parkview/blot/hardware/motor-control-board/circuit/V2_PH/motor-controller-pcb/Screenshots/Blot_PCB_Front_v2.1b1.png

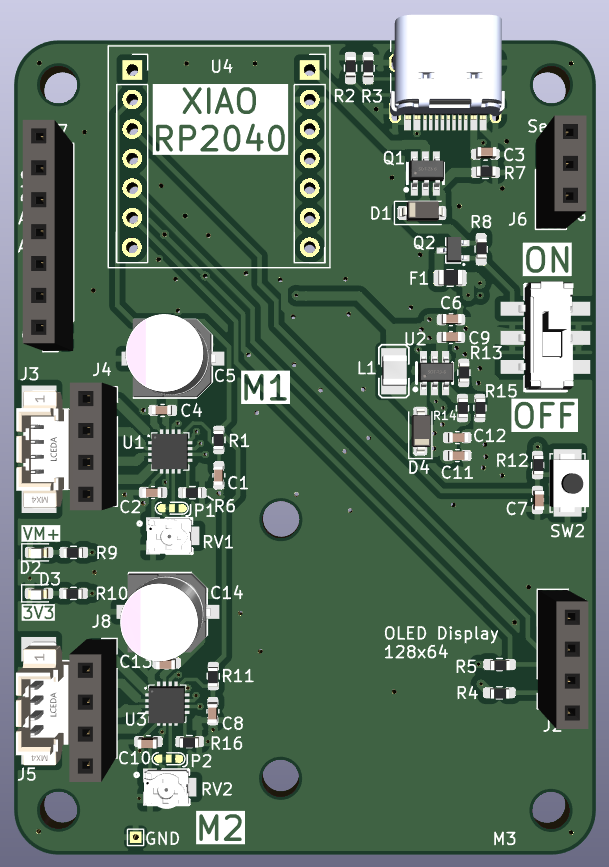
hardware/motor-control-board/circuit/V2_PH/motor-controller-pcb/Screenshots/Blot_PCB_Front_v2.1b1.png
