parkview/blot/hardware/motor-control-board/circuit/V2_PH/motor-controller-pcb/Version_2.1b1/Boost-Resistor-Selection.ods

FP6291LR-G1 Boost Resistor Selection
Vin | 5
R9 (R2) | 12000
R8 (R1) | 168000
Vout | 9
R8 = ((Vout/0.6) - 1) *R9
