parkview/blot/hardware/motor-control-board/circuit/V2_PH/motor-controller-pcb/blot_motor-controller_schematic_v2.2b1.pdf

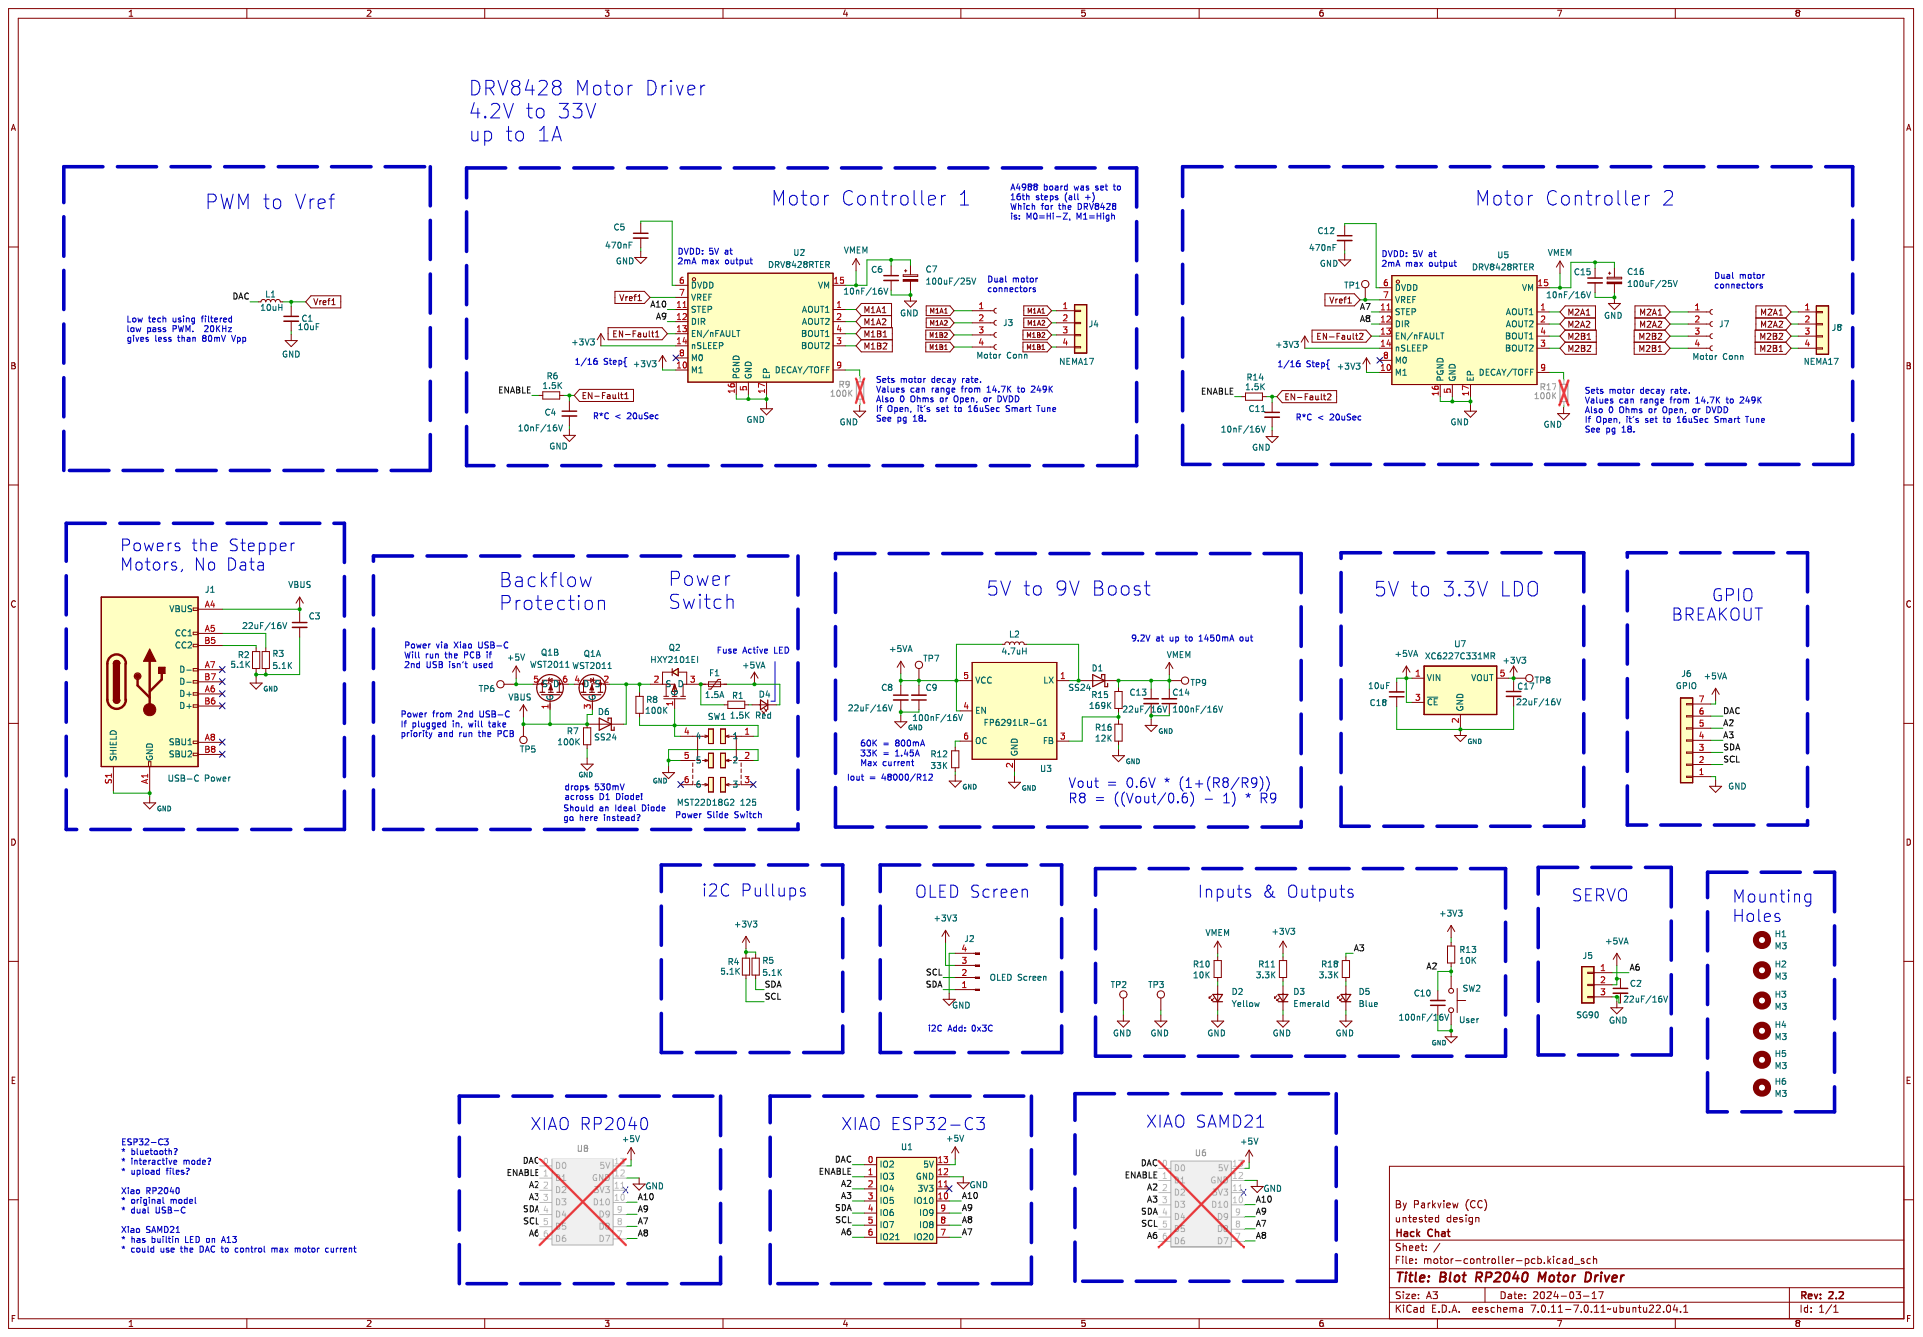
[picture p5: page 1]
