parkview/blot/hardware/motor-control-board/circuit/V2_PH/motor-controller-pcb/Version_2.1b1/blot_motor-controller_schematic_v2.1b5.pdf

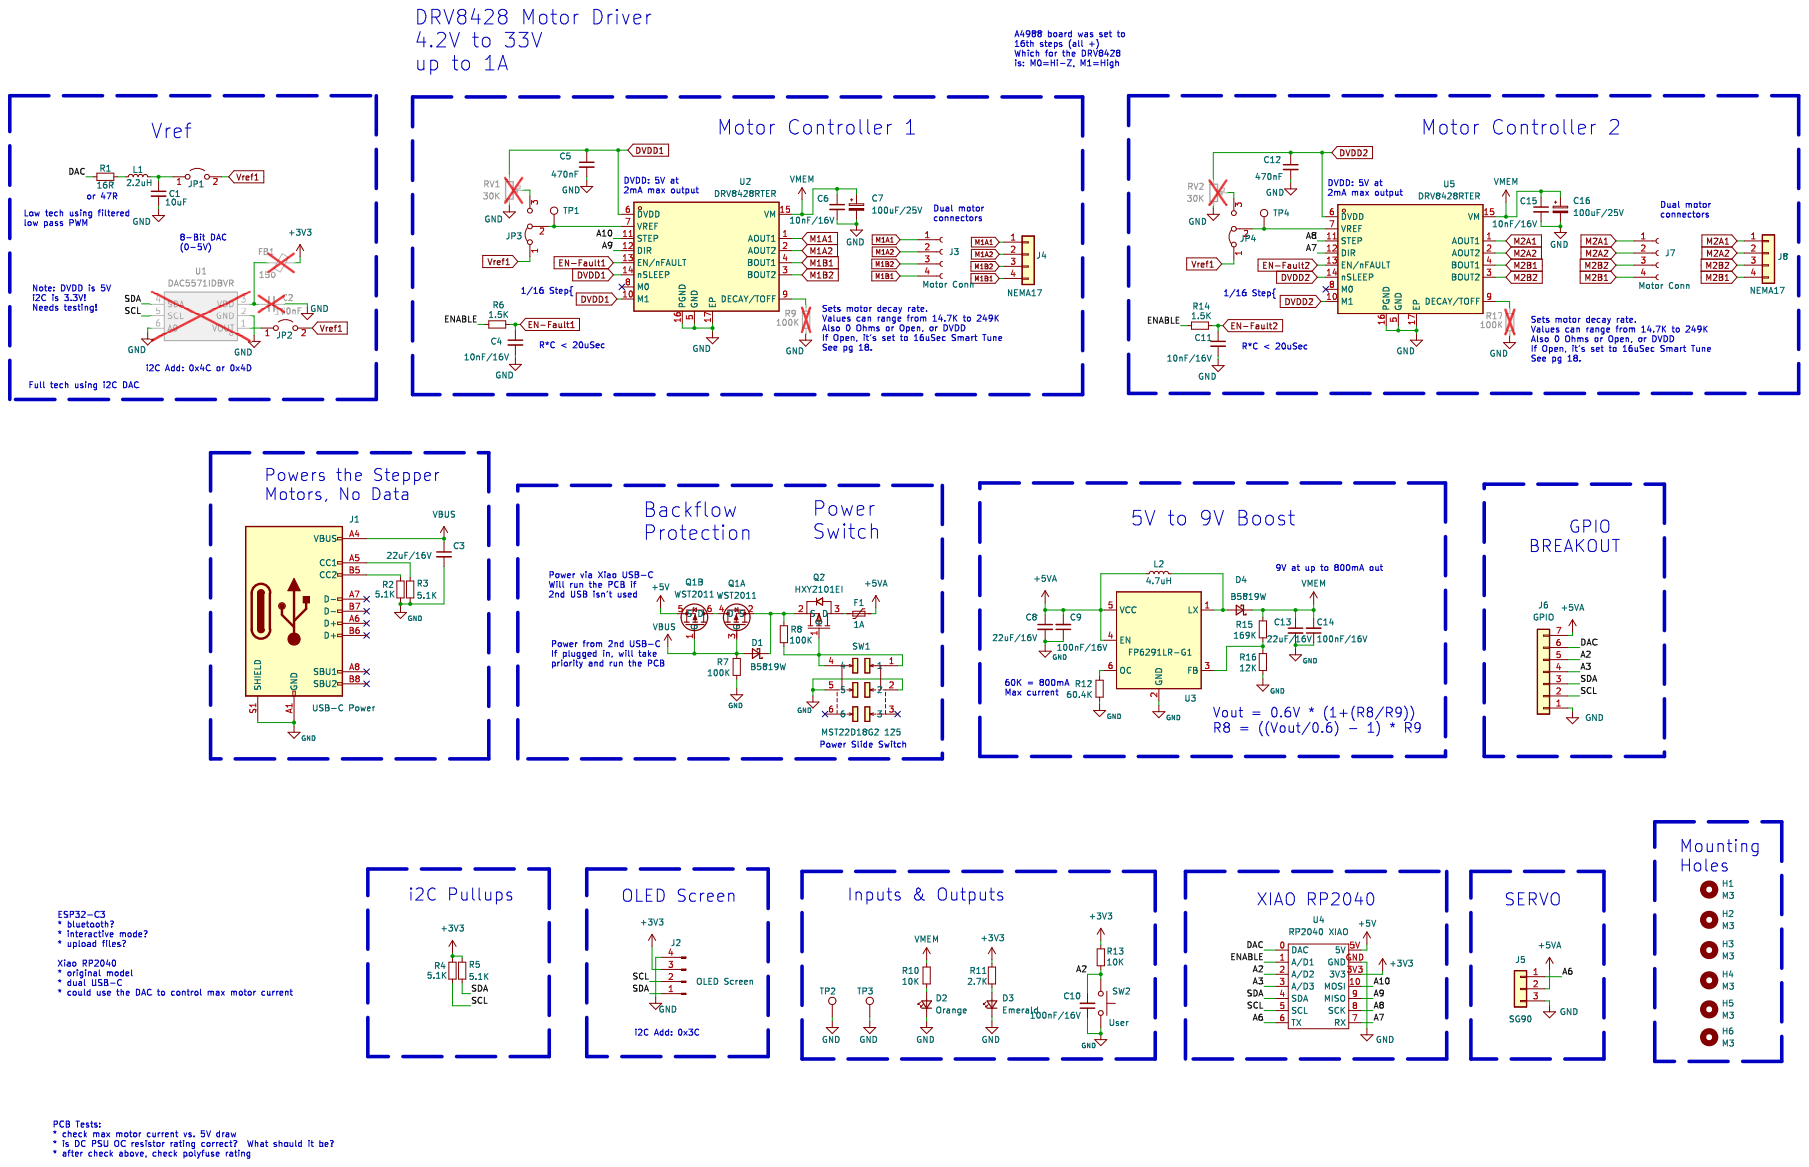
[picture p6: page 1]
