parkview/blot/hardware/motor-control-board/circuit/V2_PH/motor-controller-pcb/Version_2.1b2/motor-controller-pcb.kicad_pcb

## KiCad design hardware/motor-control-board/circuit/V2_PH/motor-controller-pcb/Version_2.1b2/motor-controller-pcb.kicad_pcb (2024-03-24)

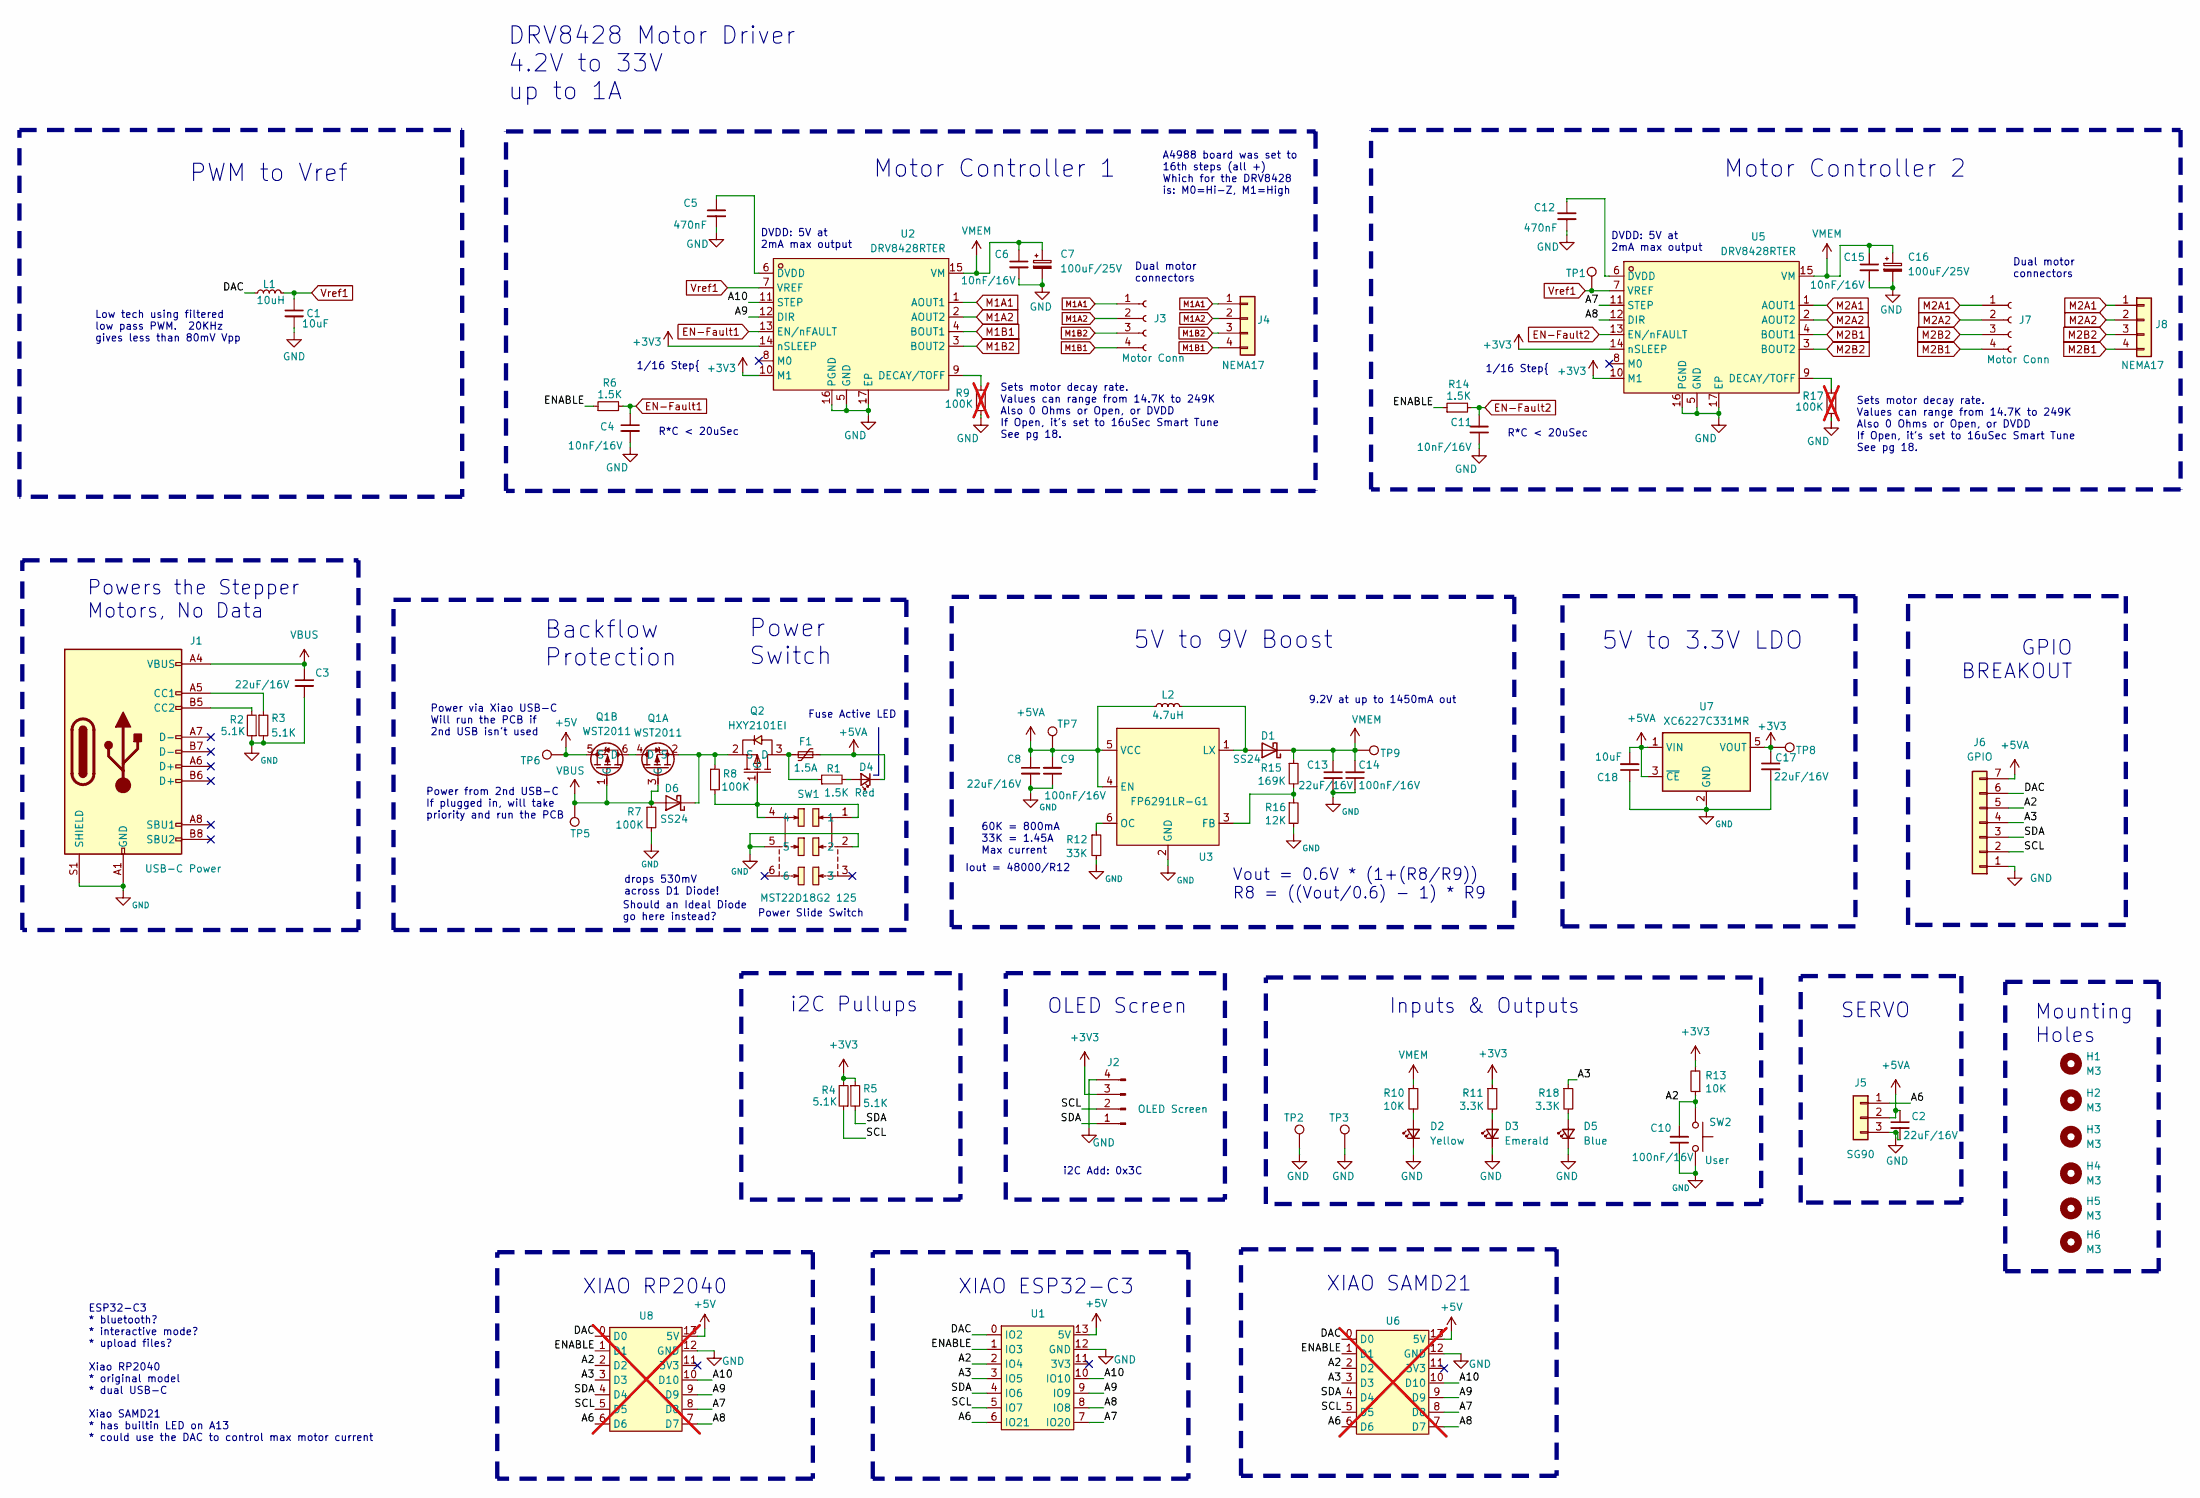
[picture p7: schematic motor-controller-pcb.kicad_sch, Blot RP2040 Motor Driver]

Parts:
C1, C18: 10uF; C_0603_1608Metric; JLC Part 50V
C2, C3, C8, C13, C17: 22uF/16V; C_0603_1608Metric; LCSC C6119868
C4, C6, C11, C15: 10nF/16V; C_0603_1608Metric; LCSC C519406
C5, C12: 470nF; C_0603_1608Metric; LCSC C106851
C7, C16: 100uF/25V; CAP-SMD_BD6.3-L6.6-W6.6-LS7.3-FD; LCSC C4747964
C9, C10, C14: 100nF/16V; C_0603_1608Metric; LCSC C30926
D1, D6: SS24; D_SMA; LCSC C466490
D2: Yellow; LED_0603_1608Metric; LCSC C965802
D3: Emerald; LED_0603_1608Metric; LCSC C965804
D4: Red; LED_0603_1608Metric; LCSC C965799
D5: Blue; LED_0603_1608Metric; LCSC C965807
F1: 1.5A; Fuse_0805_2012Metric; LCSC C269104
H1, H2, H3, H4, H5, H6: M3; MountingHole_3.2mm_M3; LCSC X
J1: USB-C Power; USB_C_Receptacle_HRO_TYPE-C-31-M-12; LCSC C2765186
J2: OLED Screen; PinSocket_1x04_P2.54mm_Vertical; LCSC C2691448
J3, J7: Motor Conn; CONN-SMD_4P-P1.25_533980471; LCSC C2845390
J4, J8: NEMA17; PinSocket_1x04_P2.54mm_Vertical; LCSC C2845390
J5: SG90; PinSocket_1x03_P2.54mm_Vertical; LCSC C2937625
J6: GPIO; PinSocket_1x07_P2.54mm_Vertical; LCSC X
L1: 10uH; L_0603_1608Metric; LCSC C51942
L2: 4.7uH; IND-SMD_L4.4-W4.2; LCSC C5159366
Q1: WST2011; SOT-23-6_L2.9-W1.6-P0.95-LS2.8-BR; LCSC Part C148368
Q2: HXY2101EI; SOT-323-3_L2.1-W1.3-P1.30-LS2.3-BL; LCSC Part C5148643
R1, R6, R14: 1.5K; R_0603_1608Metric; LCSC C22843
R2, R3, R4, R5: 5.1K; R_0603_1608Metric; LCSC C23186
R7, R8: 100K; R_0603_1608Metric; LCSC C14675
R9, R17: 100K; R_0603_1608Metric; LCSC C14675; not fitted
R10, R13: 10K; R_0603_1608Metric; LCSC C98220
R11, R18: 3.3K; R_0603_1608Metric; LCSC C114612
R12: 33K; R_0603_1608Metric; LCSC C4216
R15: 169K; R_0603_1608Metric; LCSC C137791
R16: 12K; R_0603_1608Metric; LCSC C22790
SW1: MST22D18G2 125; SW-SMD_MST22D18G2; LCSC Part C2906280
SW2: User; SW_SMD_SPST_5x3; LCSC C843665
TP1, TP2, TP3, TP5, TP6, TP7, TP8, TP9: TestPoint; TestPoint_THTPad_1.0x1.0mm_Drill0.5mm; LCSC X
U1: QTPYXIAORP2040; LCSC X
U2, U5: DRV8428RTER; WQFN-16_L3.0-W3.0-P0.50-BL-EP1.7; LCSC Part C2857955
U3: FP6291LR-G1; SOT-23-6_L2.9-W1.6-P0.95-LS2.8-BR; LCSC Part C18701
U6, U8: QTPYXIAORP2040; LCSC X; not fitted
U7: XC6227C331MR; SOT-23-5; LCSC C216640

Connections:
+3V3: C17.1, J2.3, R4.2, R5.1, R11.1, R13.2, TP8.1, U2.10 (M1), U2.14 (nSLEEP), U5.10 (M1), U5.14 (nSLEEP), U7.5 (VOUT)
+5V: Q1.5 (S), TP6.1, U1.13 (5V), U6.13 (5V), U8.13 (5V)
+5VA: C2.1, C8.1, C9.2, C18.2, D4.1 (K), F1.2, J5.2, J6.7, L2.1, TP7.1, U3.4 (EN), U3.5 (VCC), U7.1 (VIN), U7.3 (~CE)
/A2: C10.2, J6.5, R13.1, SW2.1, U1.2 (IO4), U6.2 (D2), U8.2 (D2)
/A3: J6.4, R18.1, U1.3 (IO5), U6.3 (D3), U8.3 (D3)
/A6: J5.1, U1.6 (IO21), U6.6 (D6), U8.6 (D6)
/A7: U1.7 (IO20), U5.11 (STEP), U6.8 (D8), U8.8 (D8)
/A8: U1.8 (IO8), U5.12 (DIR), U6.7 (D7), U8.7 (D7)
/A9: U1.9 (IO9), U2.12 (DIR), U6.9 (D9), U8.9 (D9)
/A10: U1.10 (IO10), U2.11 (STEP), U6.10 (D10), U8.10 (D10)
/DAC: J6.6, L1.1, U1.0 (IO2), U6.0 (D0), U8.0 (D0)
/ENABLE: R6.1, R14.1, U1.1 (IO3), U6.1 (D1), U8.1 (D1)
/SCL: J2.2, J6.2, R4.1, U1.5 (IO7), U6.5 (D5), U8.5 (D5)
/SDA: J2.1, J6.3, R5.2, U1.4 (IO6), U6.4 (D4), U8.4 (D4)
EN-Fault1: C4.1, R6.2, U2.13 (EN/nFAULT)
EN-Fault2: C11.1, R14.2, U5.13 (EN/nFAULT)
GND: C1.2, C2.2, C3.2, C4.2, C5.2, C6.2, C7.2, C8.2, C9.1, C10.1, C11.2, C12.2, C13.2, C14.1, C15.2, C16.2, C17.2, C18.1, D2.1 (K), D3.1 (K), D5.1 (K), J1.A1 (GND), J1.A12 (GND), J1.B1 (GND), J1.B12 (GND), J1.S1 (SHIELD), J2.4, J5.3, J6.1, R2.1, R3.2, R7.2, R9.1, R12.2, R16.2, R17.1, SW1.2, SW1.5, SW2.2, TP2.1, TP3.1, U1.12 (GND), U2.5 (GND), U2.16 (PGND), U2.17 (EP), U3.2 (GND), U5.5 (GND), U5.16 (PGND), U5.17 (EP), U6.12 (GND), U7.2 (GND), U8.12 (GND)
M1A1: J3.1, J4.1, U2.1 (AOUT1)
M1A2: J3.2, J4.2, U2.2 (AOUT2)
M1B1: J3.4, J4.4, U2.4 (BOUT1)
M1B2: J3.3, J4.3, U2.3 (BOUT2)
M2A1: J7.1, J8.1, U5.1 (AOUT1)
M2A2: J7.2, J8.2, U5.2 (AOUT2)
M2B1: J7.4, J8.4, U5.4 (BOUT1)
M2B2: J7.3, J8.3, U5.3 (BOUT2)
unnamed: D1.2 (A), L2.2, U3.1 (LX)
unnamed: D2.2 (A), R10.2
unnamed: D3.2 (A), R11.2
unnamed: D4.2 (A), R1.2
unnamed: D5.2 (A), R18.2
unnamed: D6.1 (K), Q1.2 (S), Q2.2 (S), R8.1
unnamed: J1.A5 (CC1), R3.1
unnamed: J1.B5 (CC2), R2.2
unnamed: Q1.4 (D), Q1.6 (D)
unnamed: F1.1, Q2.3 (D), R1.1
unnamed: Q2.1 (G), R8.2, SW1.1, SW1.4
unnamed: R9.2, U2.9 (DECAY/TOFF)
unnamed: C5.1, U2.6 (DVDD)
unnamed: R15.2, R16.1, U3.3 (FB)
unnamed: R12.1, U3.6 (OC)
unnamed: R17.2, U5.9 (DECAY/TOFF)
unnamed: C12.1, U5.6 (DVDD)
VBUS: C3.1, D6.2 (A), J1.A4 (VBUS), J1.A9 (VBUS), J1.B4 (VBUS), J1.B9 (VBUS), Q1.1 (G), Q1.3 (G), R7.1, TP5.1
VMEM: C6.1, C7.1, C13.1, C14.2, C15.1, C16.1, D1.1 (K), R10.1, R15.1, TP9.1, U2.15 (VM), U5.15 (VM)
Vref1: C1.1, L1.2, TP1.1, U2.7 (VREF), U5.7 (VREF)

Notes on the sheet:
XIAO ESP32-C3
Inputs & Outputs
5V to 9V Boost
GPIO BREAKOUT
Power via Xiao USB-C Will run the PCB if 2nd USB isn't used
Backflow Protection
DRV8428 Motor Driver 4.2V to 33V up to 1A
PWM to Vref
Fuse Active LED
R*C < 20uSec
Mounting Holes
Dual motor connectors
DVDD: 5V at 2mA max output
Power from 2nd USB-C If plugged in, will take priority and run the PCB
Power Switch
Power Slide Switch
XIAO RP2040
Sets motor decay rate. Values can range from 14.7K to 249K Also 0 Ohms or Open, or DVDD If Open, it's set to 16uSec Smart Tune See pg 18.
OLED Screen
i2C Pullups
Iout = 48000/R12
Motor Controller 2
Low tech using filtered low pass PWM. 20KHz gives less than 80mV Vpp
XIAO SAMD21
9.2V at up to 1450mA out
Powers the Stepper Motors, No Data
5V to 3.3V LDO
1/16 Step{
ESP32-C3 * bluetooth? * interactive mode? * upload files? Xiao RP2040 * original model * dual USB-C Xiao SAMD21 * has builtin LED on A13 * could use the DAC to control max motor current
SERVO
A4988 board was set to 16th steps (all +) Which for the DRV8428 is: M0=Hi-Z, M1=High
Motor Controller 1
Should an Ideal Diode go here instead?
i2C Add: 0x3C
drops 530mV across D1 Diode!
60K = 800mA 33K = 1.45A Max current
Vout = 0.6V * (1+(R8/R9)) R8 = ((Vout/0.6) - 1) * R9

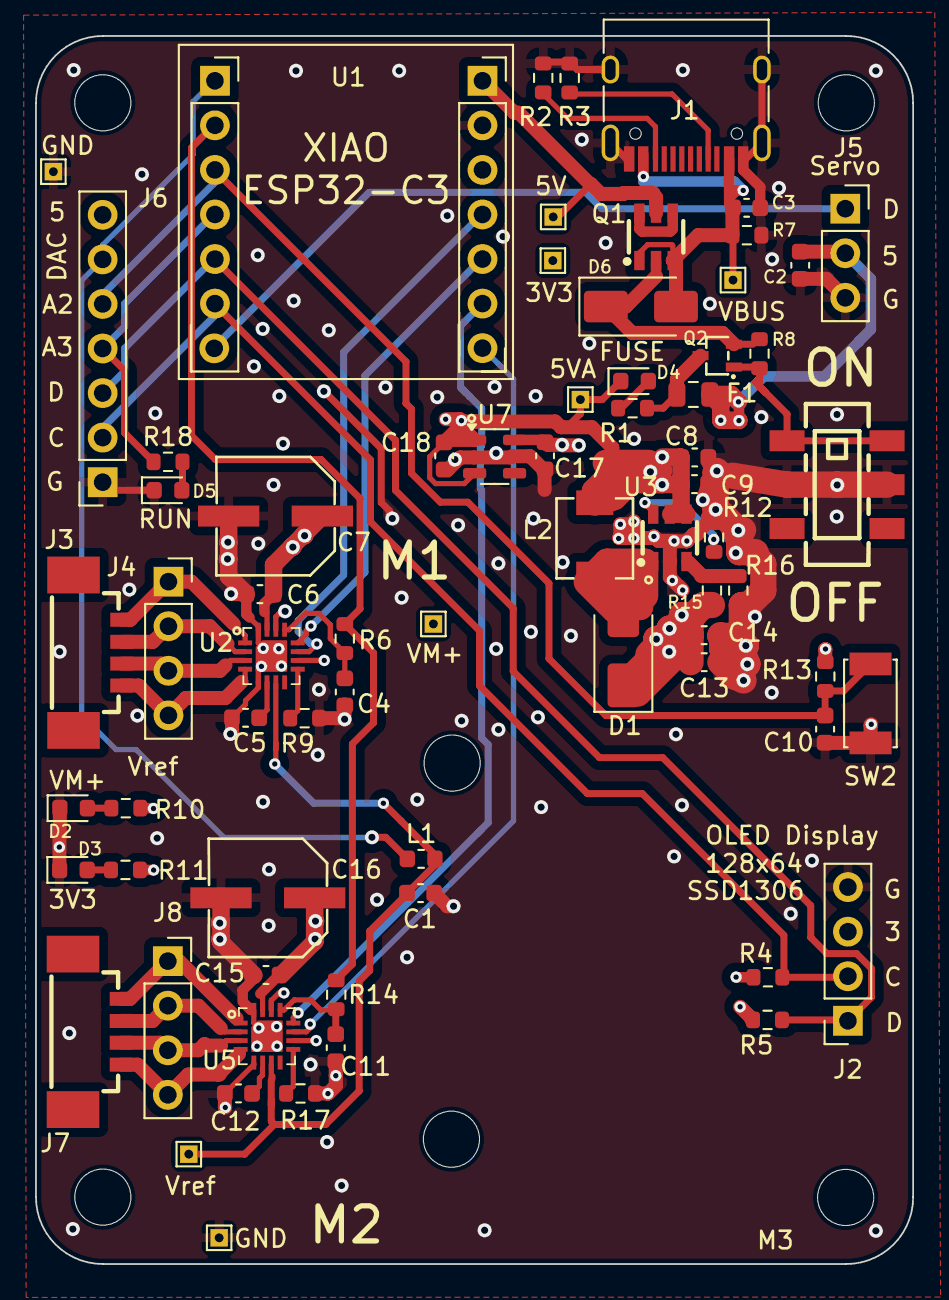
[picture p8: board motor-controller-pcb.kicad_pcb from above]

Board: 4 copper layers, 50.0 x 70.0 mm, 76 parts (0 on the bottom side), 45 nets.
