parkview/blot/(commit log)

2024-02-13 adding initial V2-beta schematic and PCB layout
    [Boost-Resistor-Selection.ods, USBPD.kicad_sch, motor-controller-pcb.kicad_pcb, motor-controller-pcb.kicad_sch]
2024-02-13 PCB ready for manufacture
    [motor-controller-pcb-B_Cu.gbl, motor-controller-pcb-B_Mask.gbs, motor-controller-pcb-B_Paste.gbp, motor-controller-pcb-B_Silkscreen.gbo, motor-controller-pcb-Edge_Cuts.gm1, motor-controller-pcb-F_Cu.gtl, motor-controller-pcb-F_Mask.gts, motor-controller-pcb-F_Paste.gtp]
2024-02-13 adding PCB schematic PDF
    [motor-controller-pcb.kicad_pcb, motor-controller-pcb.kicad_sch]
2024-02-13 updated components with LCSC part numbers
    [motor-controller-pcb.kicad_sch]
2024-02-13 updated schematic PDF and added more datasheet
2024-02-19 adding in new PWM/DAC design
    [Blot_Motor-Controller-PCB_BOM_v0.1.csv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]
2024-03-02 cleaned up Silkscreen errors
    [motor-controller-pcb.kicad_pcb]
2024-03-24 adding in new Blot PVB version v2.1b2
    [Blot-motor-controller-pcb_BOM_v2.1b2.csv, Blot_Motor-Controller-PCB_BOM_v0.1.csv, Blot_Motor-Controller-PCB_BOM_v0.1a.csv, Blot_Motor-Controller-PCB_BOM_v0.1a.ods, Boost-Resistor-Selection.ods, USBPD.kicad_sch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]
2024-03-24 adding in schematic
    [Blot_Motor-Controller-PCB_BOM_v0.1a.csv, Blot_Motor-Controller-PCB_BOM_v0.1a.ods]
